dan-1d/GlideTime/hardware/bill_of_materials.txt

Description, Purchase Link
Arduino clone "Pro Mini" 3.3V, https://www.aliexpress.com/item/Free-Shipping-1pcs-pro-mini-atmega328-Pro-Mini-328-Mini-ATMEGA328-3-3V-8MHz-for-Arduino/32342672626.html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
