dan-1d/GlideTime/hardware/Schematic_f3k-timer_schematic-v1.0_20190405225800.pdf

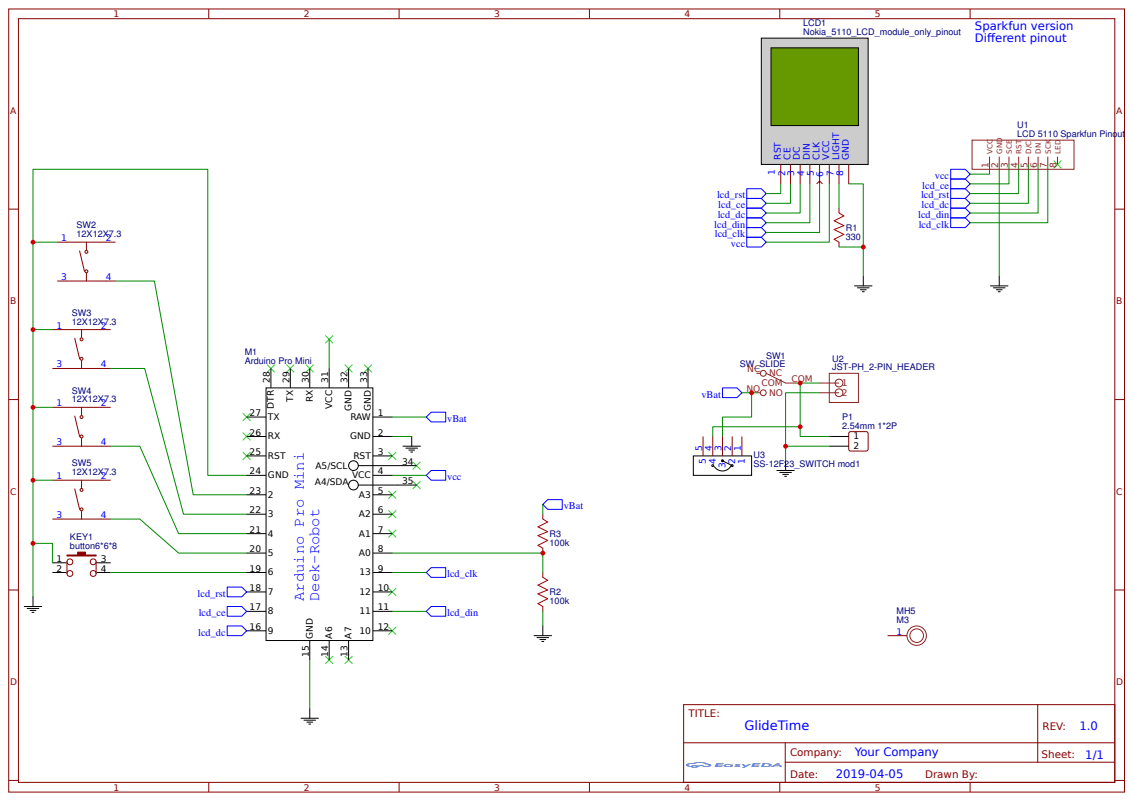
[picture p1: page 1]
