dan-1d/GlideTime/(threads)

Thread 2 (2019-04-09):

Incremental display changes rather than full refresh

dan-1d, 2019-04-09:
Redrawing display every 10th second is too slow when using many custom fonts. Button presses are missed often.
Partial updates may prevent this and allow cleaner and more compact fonts to be used

Thread 5 (2019-04-16):

PCB changes

dan-1d, 2019-04-16:
- Ground plane does not seem to have been properly created in fabricated boards
- Must connect FTDI port ground to system ground

dan-1d, 2019-04-16:
Fixed on the EasyEda design. Re-drew ground plane and it seems to work now

Closed 2019-04-16.

Thread 6 (2019-04-17):

Voltage display of supply battery

dan-1d, 2019-04-17:
Circuit side:  want a 2s lipo voltage range, so:
Vbat --- 47k ---<ADC>---27k---GND

Yields
Vadc = 3.065 for Vbat=8.4

dan-1d, 2019-05-25:
Added to bootup screen

Closed 2019-05-25.

Thread 8 (2019-04-17):

Configuration Mode

dan-1d, 2019-04-17:
Want to have a configuration mode:
- adjust LCD contrast
- calibrate Vbat ADC.

dan-1d, 2019-05-25:
Configuration screen is entered by holding down both keys upon boot. Currently only auto-calibration is available.

TODO:
- manual calibration adjustment
- LCD contrast
