dan-1d/GlideTime/(commit log)

2019-03-27 added main Arduino code
2019-04-06 updated pins to match schematic and PCB v.1.0. Added schematic
2019-04-16 many changes; working prototype
2019-04-24 start of serial communication between python script and arduino. Problem with auto-reset.
    [clock_calibration.py]
2019-04-24 calibration serial comms working
2019-04-25 working calibration, but it doesn't seem to solve the underlying clock slowness
    [GlideTime.cpp, GlideTime.h, clock_calibration.py, glideTime.ino]
2019-04-28 refactor working. Need proper calibration.
2019-05-05 re-work of calibration done.. but still time is not accurate
2019-05-05 extended calibration time to 3 minutes. Seems to work much better
2019-05-10 calibration seems to work. 1-minute period OK. Battery voltage correction made.
    [GlideTimeConfig.cpp, GlideTimeConfig.h, clock_calibration.py, consts.h, glideTime.ino]
2019-05-11 bugfix for multi-minute calibration periods
    [GlideTimeConfig.cpp]
